vattern/holiot-carrier/README.md

# holiot-carrier
Carrirer board for Holyiots to fit BastardKB housings

PLEASE NOTE: These boards have to be angled when inserting them.

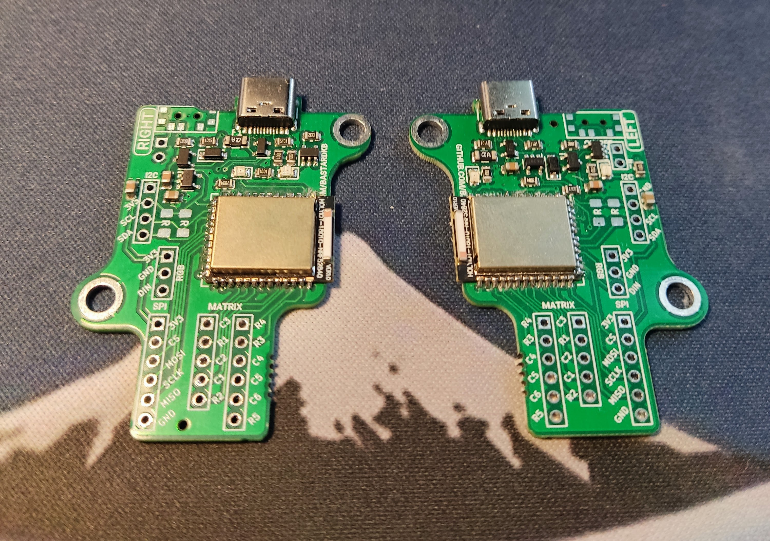
[picture p1: images/pair.jpg]

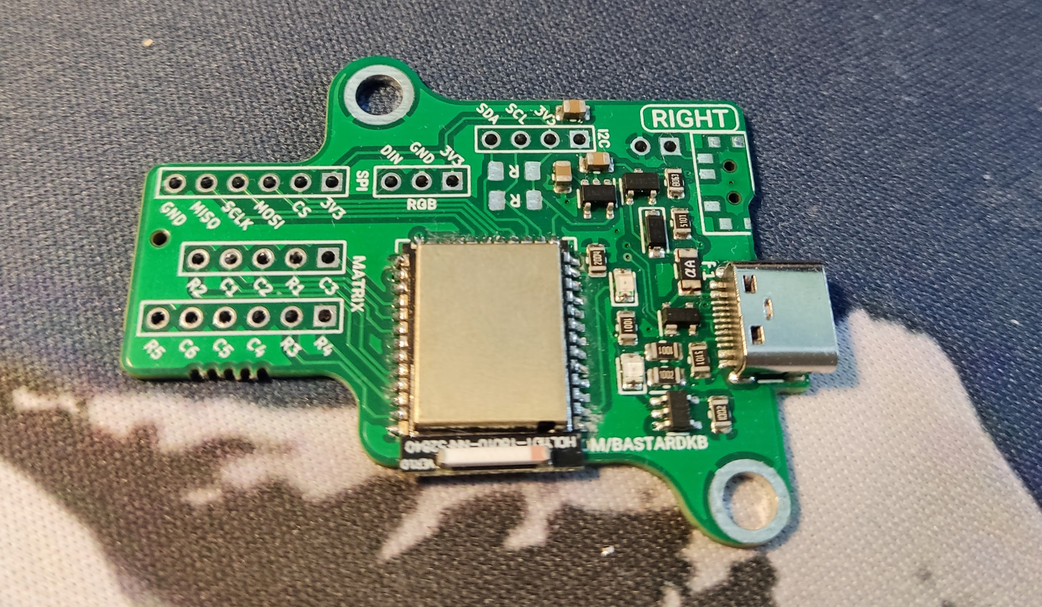
[picture p2: images/right.jpg]
