vattern/holiot-carrier/PCB/PRODUCTION_FILES/bom.xls

Comment | Designator | Footprint | JLCPCB Part #
1k | R7,R12,R14,R19 | R_0805_2012Metric | C17513
806k | R11,R18 | R_0805_2012Metric | C63494
USB_C_Receptacle | J1,J2 | USB_C_Receptacle_HRO_TYPE-C-31-M-12 | C165948
2M | R13,R20 | R_0805_2012Metric | C26112
POWERLED | D1,D5 | D_0805_2012Metric | C84256
1uF | C2,C3,C5,C6 | C_0805_2012Metric | C28323
4.7uF | C1,C4 | C_0805_2012Metric | C1779
500ma | F1,F2 | Fuse_1206_3216Metric | C70068
TP4054 | U1,U2 | SOT-23-5 | C32574
10k | R5,R6,R10,R17 | R_0805_2012Metric | C17414
SR05 | D2,D6 | SOT-143 | C521962
AO3401A | Q1,Q2 | SOT-23 | C15127
1N5819 | D3,D7 | D_SOD-123 | C963381
AP2112K-3.3 | U3,U5 | SOT-23-5 | C86534
LED_Small | D4,D8 | D_0805_2012Metric | C2296
5.1k | R8,R9,R15,R16 | R_0805_2012Metric | C27834
