vattern/holiot-carrier/PCB/PRODUCTION_FILES/BOM-adapter-holyiot.csv

Comment | Designator | Footprint | LCSC
TP4054 | U1,U2 | SOT-23-5 | C32574
5.1k | D1,Q1,F1,C1,Q2,F2,C2,D2,D3,C3,U3,C4,D4,U5,C5,D5,C6,D6,R7,D7,R8,D8,R9,R10,R11,R12,R13,R14,R15,J15,R16,J16,R17,R18,R19,R20 | R_0805_2012Metric
10k | R5,R6 | R_0805_2012Metric | C17414
USB_C_Receptacle | J1,J2 | USB_C_Receptacle_HRO_TYPE-C-31-M-12 | C165948
