vattern/holiot-carrier/PCB/adapter-holyiot.kicad_pcb

## KiCad design PCB/adapter-holyiot.kicad_pcb (2022-06-24)

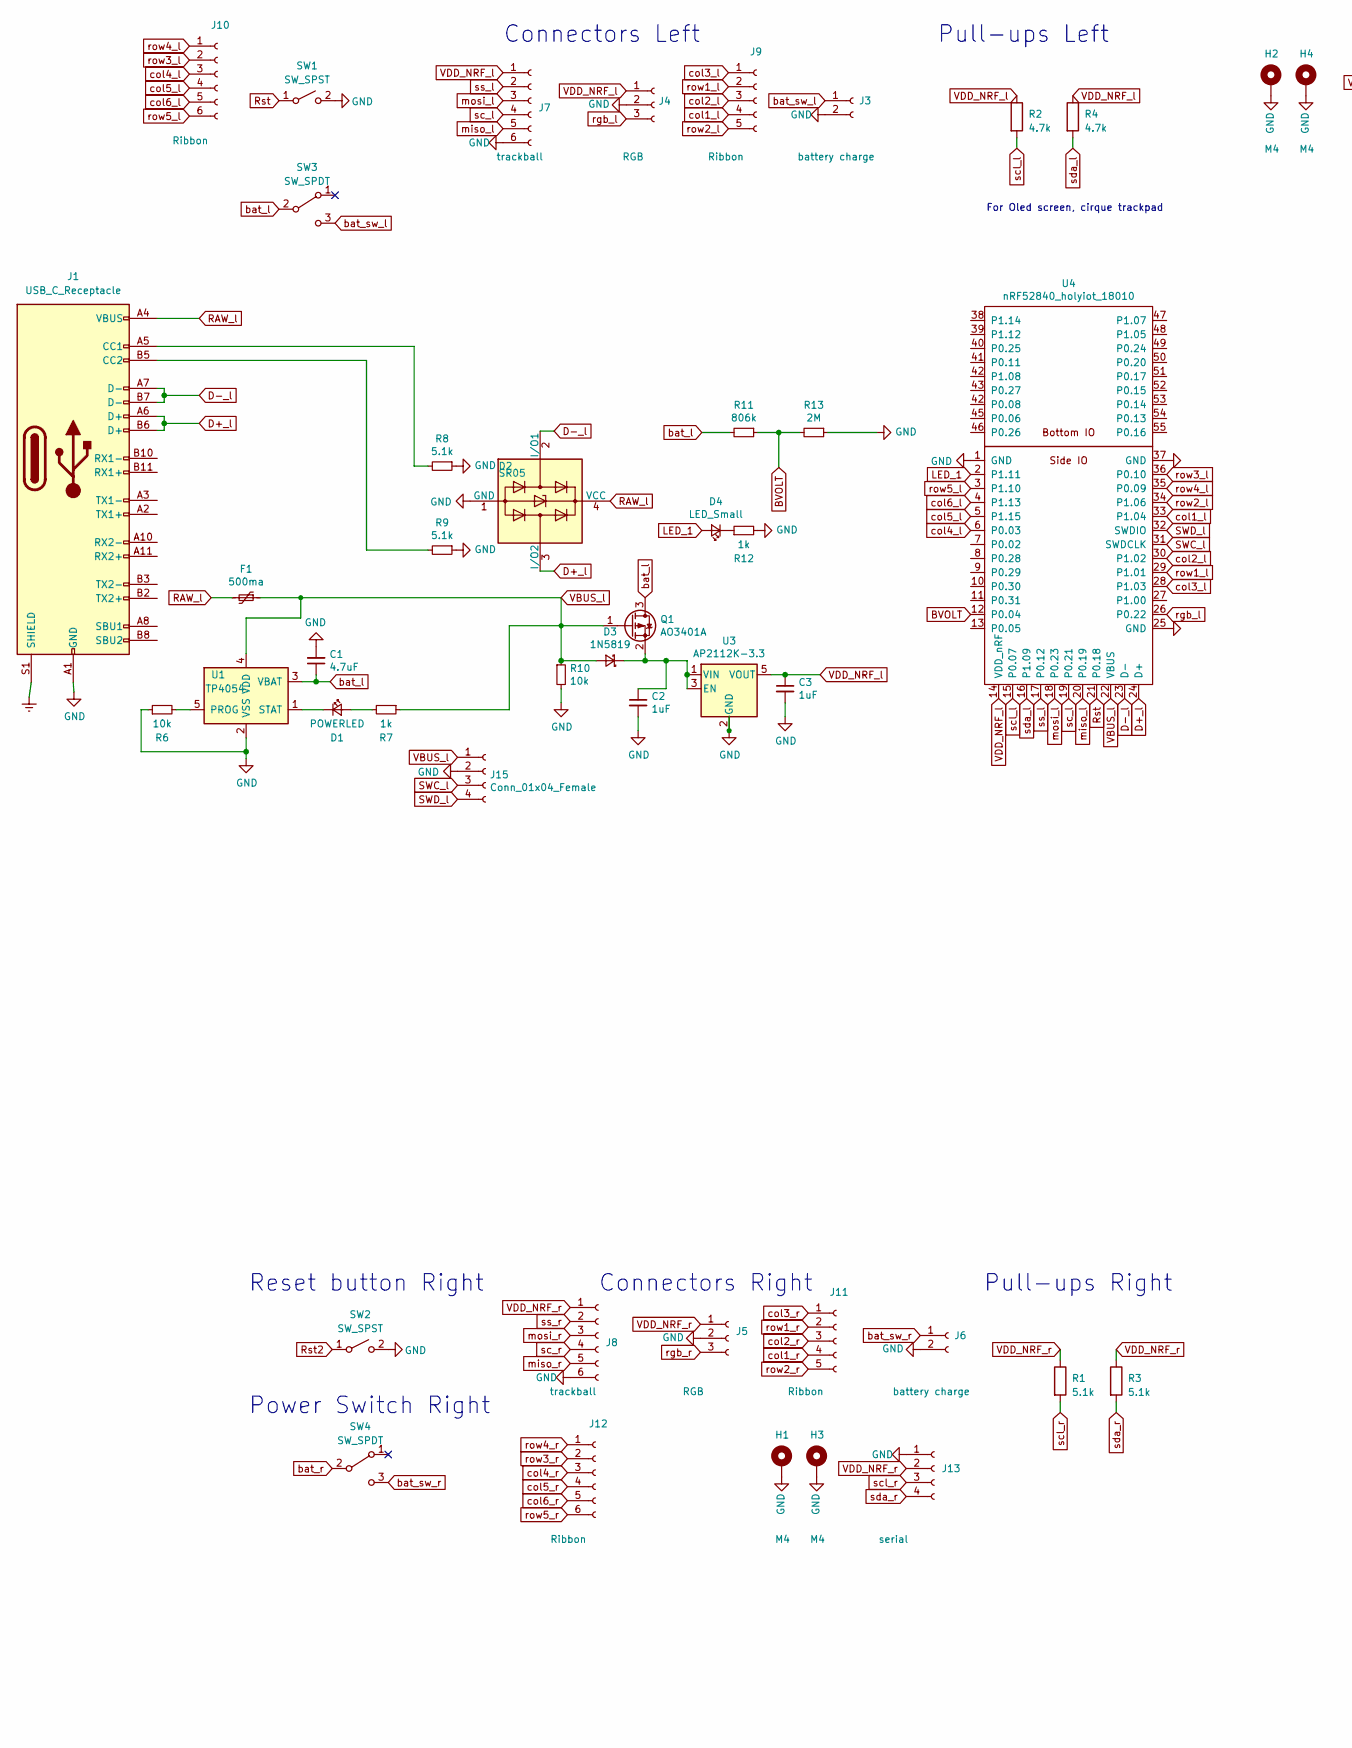
[picture p3: schematic adapter-holyiot.kicad_sch, Holyiot Carrier, part in row 1, column 1]

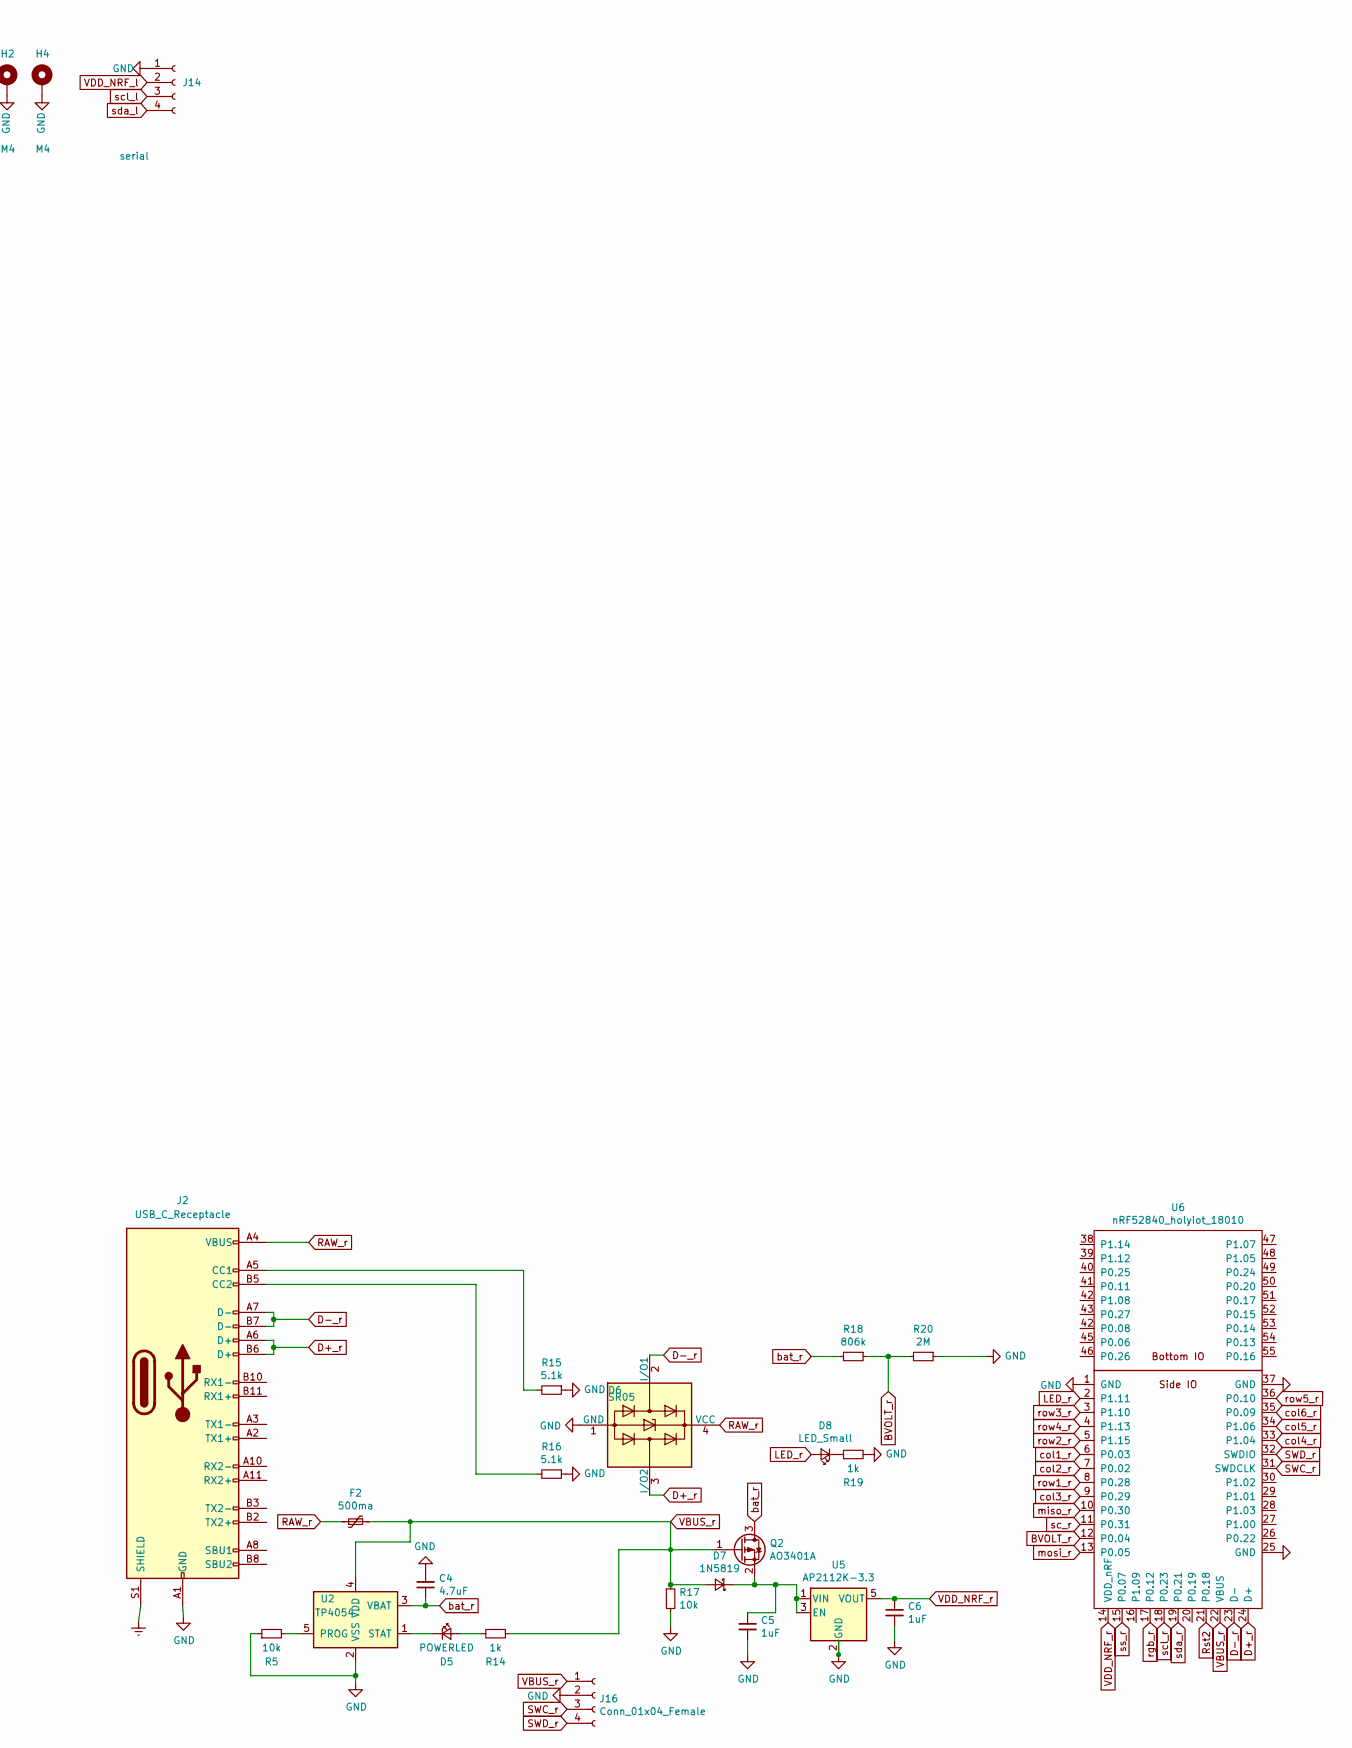
[picture p4: schematic adapter-holyiot.kicad_sch, Holyiot Carrier, part in row 1, column 2]

Parts:
C1, C4: 4.7uF; C_0805_2012Metric
C2, C3, C5, C6: 1uF; C_0805_2012Metric
D1, D5: POWERLED; D_0805_2012Metric
D2, D6: SR05; SOT-143
D3, D7: 1N5819; D_SOD-123
D4, D8: LED_Small; D_0805_2012Metric
F1, F2: 500ma; Fuse_1206_3216Metric
H1, H2, H3, H4: M4; MountingHole_4mm_Pad_thin
J1, J2: USB_C_Receptacle; USB_C_Receptacle_HRO_TYPE-C-31-M-12
J3, J6: battery charge; PinHeader_1x02_P2.54mm_Vertical
J4, J5: RGB; header1x03
J7, J8: trackball; 6_PinHeader
J9, J11: Ribbon; 5_PinHeader
J10, J12: Ribbon; 6_PinHeader
J13, J14: serial; PinHeader_1x04_P2.54mm_Vertical
J15, J16: Conn_01x04_Female; PRO-HDR
Q1, Q2: AO3401A; SOT-23
R1, R3: 5.1k; R_1206_handsolder; JLCPCB BOM 1
R2, R4: 4.7k; R_1206_handsolder; JLCPCB BOM 1
R5, R6, R10, R17: 10k; R_0805_2012Metric
R7, R12, R14, R19: 1k; R_0805_2012Metric
R8, R9, R15, R16: 5.1k; R_0805_2012Metric
R11, R18: 806k; R_0805_2012Metric
R13, R20: 2M; R_0805_2012Metric
SW1, SW2: SW_SPST; PushSwitch
SW3, SW4: SW_SPDT; SW_SPDT+H-MSK12C01_hor(7pin_SMD)
U1, U2: TP4054; SOT-23-5
U3, U5: AP2112K-3.3; SOT-23-5
U4, U6: nRF52840_holyiot_18010

Connections:
BVOLT: R11.1, R13.2, U4.12 (P0.04)
BVOLT_r: R18.1, R20.2, U6.12 (P0.04)
D+_l: D2.3 (I/O2), J1.A6 (D+), J1.B6 (D+), U4.24 (D+)
D+_r: D6.3 (I/O2), J2.A6 (D+), J2.B6 (D+), U6.24 (D+)
D-_l: D2.2 (I/O1), J1.A7 (D-), J1.B7 (D-), U4.23 (D-)
D-_r: D6.2 (I/O1), J2.A7 (D-), J2.B7 (D-), U6.23 (D-)
Earth: J1.S1 (SHIELD), J2.S1 (SHIELD)
GND: C1.2, C2.2, C3.2, C4.2, C5.2, C6.2, D2.1 (GND), D6.1 (GND), H1.1, H2.1, H3.1, H4.1, J1.A1 (GND), J1.A12 (GND), J1.B1 (GND), J1.B12 (GND), J2.A1 (GND), J2.A12 (GND), J2.B1 (GND), J2.B12 (GND), J3.2, J4.2, J5.2, J6.2, J7.6, J8.6, J13.1, J14.1, J15.2, J16.2, R5.1, R6.1, R8.1, R9.1, R10.2, R12.2, R13.1, R15.1, R16.1, R17.2, R19.2, R20.1, SW1.2 (B), SW2.2 (B), U1.2 (VSS), U2.2 (VSS), U3.2 (GND), U4.1 (GND), U4.25 (GND), U4.37 (GND), U5.2 (GND), U6.1 (GND), U6.25 (GND), U6.37 (GND)
LED_1: D4.2 (A), U4.2 (P1.11)
LED_r: D8.2 (A), U6.2 (P1.11)
unnamed: C2.1, D3.1 (K), Q1.2 (S), U3.1 (VIN), U3.3 (EN)
unnamed: C5.1, D7.1 (K), Q2.2 (S), U5.1 (VIN), U5.3 (EN)
unnamed: D1.1 (K), U1.1 (STAT)
unnamed: D1.2 (A), R7.2
unnamed: D4.1 (K), R12.1
unnamed: D5.1 (K), U2.1 (STAT)
unnamed: D5.2 (A), R14.2
unnamed: D8.1 (K), R19.1
unnamed: J1.A5 (CC1), R8.2
unnamed: J1.B5 (CC2), R9.2
unnamed: J2.A5 (CC1), R15.2
unnamed: J2.B5 (CC2), R16.2
unnamed: R5.2, U2.5 (PROG)
unnamed: R6.2, U1.5 (PROG)
RAW_l: D2.4 (VCC), F1.2, J1.A4 (VBUS), J1.A9 (VBUS), J1.B4 (VBUS), J1.B9 (VBUS)
RAW_r: D6.4 (VCC), F2.2, J2.A4 (VBUS), J2.A9 (VBUS), J2.B4 (VBUS), J2.B9 (VBUS)
Rst: SW1.1 (A), U4.21 (P0.18)
Rst2: SW2.1 (A), U6.21 (P0.18)
SWC_l: J15.3, U4.31 (SWDCLK)
SWC_r: J16.3, U6.31 (SWDCLK)
SWD_l: J15.4, U4.32 (SWDIO)
SWD_r: J16.4, U6.32 (SWDIO)
VBUS_l: D3.2 (A), F1.1, J15.1, Q1.1 (G), R7.1, R10.1, U1.4 (VDD), U4.22 (VBUS)
VBUS_r: D7.2 (A), F2.1, J16.1, Q2.1 (G), R14.1, R17.1, U2.4 (VDD), U6.22 (VBUS)
VDD_NRF_l: C3.1, J4.1, J7.1, J14.2, R2.1, R4.1, U3.5 (VOUT), U4.14 (VDD_nRF)
VDD_NRF_r: C6.1, J5.1, J8.1, J13.2, R1.1, R3.1, U5.5 (VOUT), U6.14 (VDD_nRF)
bat_l: C1.1, Q1.3 (D), R11.2, SW3.2 (B), U1.3 (VBAT)
bat_r: C4.1, Q2.3 (D), R18.2, SW4.2 (B), U2.3 (VBAT)
bat_sw_l: J3.1, SW3.3 (C)
bat_sw_r: J6.1, SW4.3 (C)
col1_l: J9.4, U4.33 (P1.04)
col1_r: J11.4, U6.6 (P0.03)
col2_l: J9.3, U4.30 (P1.02)
col2_r: J11.3, U6.7 (P0.02)
col3_l: J9.1, U4.28 (P1.03)
col3_r: J11.1, U6.9 (P0.29)
col4_l: J10.3, U4.6 (P0.03)
col4_r: J12.3, U6.33 (P1.04)
col5_l: J10.4, U4.5 (P1.15)
col5_r: J12.4, U6.34 (P1.06)
col6_l: J10.5, U4.4 (P1.13)
col6_r: J12.5, U6.35 (P0.09)
miso_l: J7.5, U4.20 (P0.19)
miso_r: J8.5, U6.10 (P0.30)
mosi_l: J7.3, U4.18 (P0.23)
mosi_r: J8.3, U6.13 (P0.05)
rgb_l: J4.3, U4.26 (P0.22)
rgb_r: J5.3, U6.17 (P0.12)
row1_l: J9.2, U4.29 (P1.01)
row1_r: J11.2, U6.8 (P0.28)
row2_l: J9.5, U4.34 (P1.06)
row2_r: J11.5, U6.5 (P1.15)
row3_l: J10.2, U4.36 (P0.10)
row3_r: J12.2, U6.3 (P1.10)
row4_l: J10.1, U4.35 (P0.09)
row4_r: J12.1, U6.4 (P1.13)
row5_l: J10.6, U4.3 (P1.10)
row5_r: J12.6, U6.36 (P0.10)
sc_l: J7.4, U4.19 (P0.21)
sc_r: J8.4, U6.11 (P0.31)
scl_l: J14.3, R2.2, U4.15 (P0.07)
scl_r: J13.3, R1.2, U6.18 (P0.23)
sda_l: J14.4, R4.2, U4.16 (P1.09)
sda_r: J13.4, R3.2, U6.19 (P0.21)
ss_l: J7.2, U4.17 (P0.12)
ss_r: J8.2, U6.15 (P0.07)

Notes on the sheet:
Power Switch Right
For Oled screen, cirque trackpad
Connectors Left
Pull-ups Right
Reset button Right
Pull-ups Left
Connectors Right

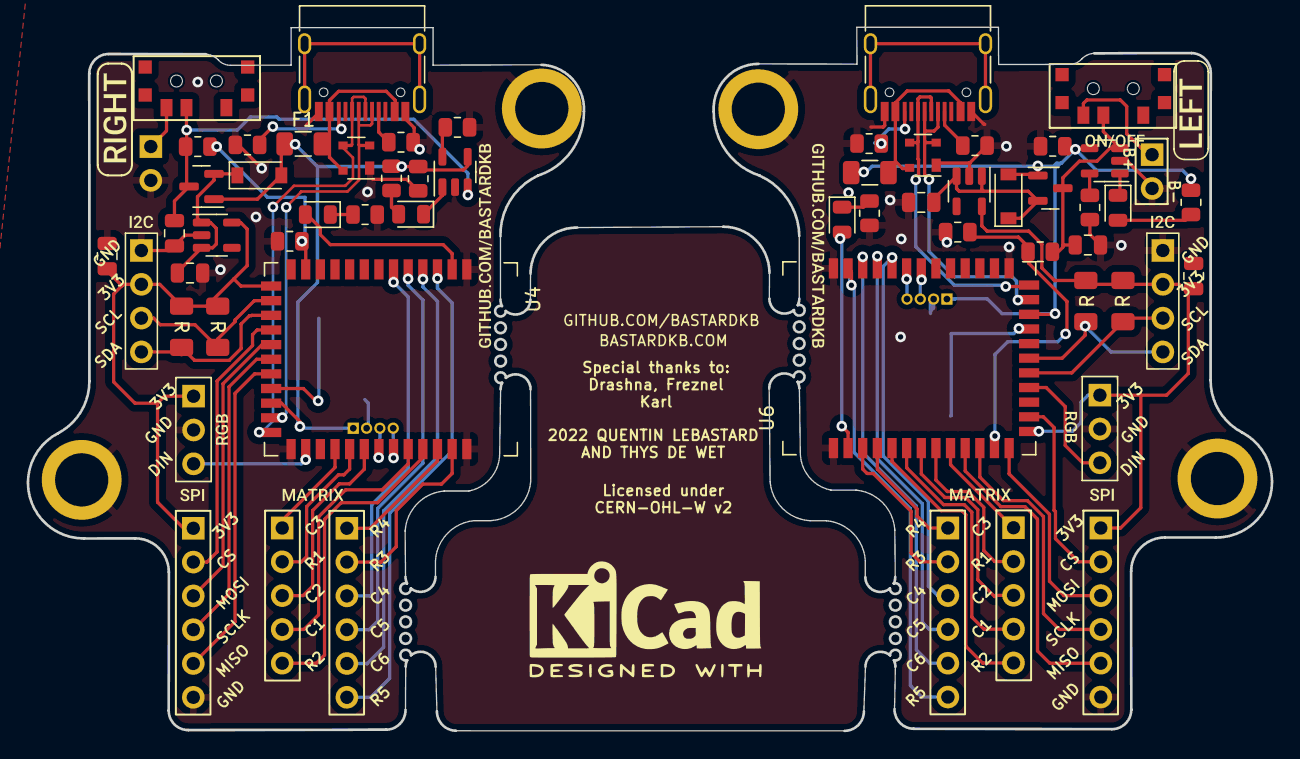
[picture p5: board adapter-holyiot.kicad_pcb from above]

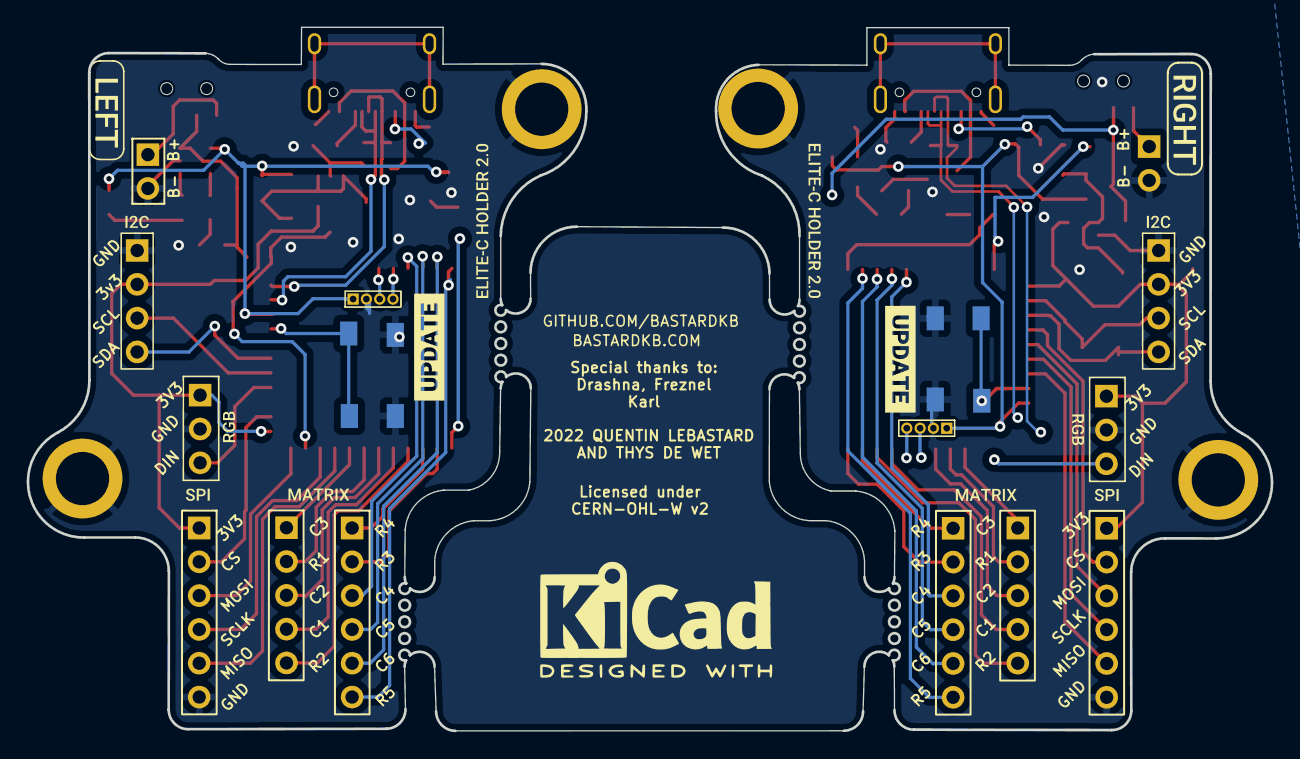
[picture p6: board adapter-holyiot.kicad_pcb from below]

Board: 2 copper layers, 93.5 x 52.9 mm, 95 parts (18 on the bottom side), 76 nets.

Other parts of the board:
kibuzzard-61F01A92, kibuzzard-61F01A92#2: G***; kibuzzard-61F01A92
kibuzzard-61F01B61, kibuzzard-61F01B61#2: G***; kibuzzard-61F01B61
kibuzzard-61F01C84, kibuzzard-61F01C84#2: G***; kibuzzard-61F01C84
kibuzzard-61F019CB, kibuzzard-61F019CB#2, kibuzzard-61F019CB#3, kibuzzard-61F019CB#4: G***; kibuzzard-61F019CB
kibuzzard-61F01940, kibuzzard-61F01940#2, kibuzzard-61F01940#3, kibuzzard-61F01940#4: G***; kibuzzard-61F01940
kibuzzard-61F01957, kibuzzard-61F01957#2, kibuzzard-61F01957#3, kibuzzard-61F01957#4: G***; kibuzzard-61F01957
kibuzzard-620B8D91, kibuzzard-620B8D91#2, kibuzzard-620B8D91#3, kibuzzard-620B8D91#4: G***; kibuzzard-620B8D91
kibuzzard-620B8593: G***; kibuzzard-620B8593
kibuzzard-6208E810, kibuzzard-6208E810#2: G***; kibuzzard-6208E810
kibuzzard-6208EFFE, kibuzzard-6208EFFE#2: G***; kibuzzard-6208EFFE
