vattern/holiot-carrier/(threads)

Thread 2 (2022-10-01):

BOM is incomplete

DasPez, 2022-10-01:
The BOM in PRODUCTIONFILES is missing a lot of parts

https://github.com/vattern/holiot-carrier/blob/2ea75663381d650d06d59db998a7086e5ef48cf4/PCB/PRODUCTION_FILES/BOM-adapter-holyiot.csv

vattern, 2022-10-02:
I've added the bom.xls JLC has for the last order. Please verify it before ordering.

Closed 2022-10-02.

Thread 3 (2022-11-10):

Charging Current

webhostsg, 2022-11-10:
Hi,

Does it support charging? If yes, what is the max charging current. Trying to figure out the best batt capacity.

vattern, 2022-11-10:
The TP4054 handles the charging , and the 10K resistor selected charges at 100mA

Closed 2022-11-10.

Thread 4 (2022-12-25):

Any guides to flashing.

webhostsg, 2022-12-25:
Never used ZMK before, so I'm not sure where to start. How do I flash the firmware to the board? Any guides?

webhostsg, 2022-12-26:
Ok nevermind, i found the SWD and SWC on the PCB

Closed 2022-12-26.

Thread 5 (2023-02-24):

SK6812 LEDs draw current when "off"

DasPez, 2023-02-24:
As the power switch of this carrier board is not easily accessible in my Skeletyl build, I am using ZMKs sleep function to power down the chip automatically after idling for some time. But it still drains a 1200mAh battery in about 4 days in the system off state.

I believe that the SK6812 LEDs are draining the battery while sleeping (without emitting any light) and suggest to add a mosfet to cut off the RGB headers from VCC. ZMK povides the [ext_power](https://zmk.dev/docs/behaviors/power#external-power-control) driver for it.

The [SK6812 data sheet](https://www.digikey.com/htmldatasheets/production/1876263/0/0/1/sk6812-datasheet.html) mentions a typical static power consumption of about 1mA.

The nice!60 keyboard for example implements such a cut off mosfet for the leds as shown in the [schematics](https://nicekeyboards.com/docs/nice-60/schematic/).

Thread 6 (2023-03-10):

Unable to pair

webhostsg, 2023-03-10:
Still a work in progress. I've decided to go with holiot-carrier for my Scylla. JLPCB did PCB with most of the SMDs soldered. Purchased Holyiot 18010 from AliExpress and soldered it on.

Used J-link to flash pca10056_bootloader-0.7.0_s140_6.1.1.hex
bootloader. Copied the zmk-config.

I was able to upload firmware on both, my Mac detected scylla, but I'm unable to connect to it successfully.

Connected left via USB and using https://keyboardchecker.com/ all the left keys registered. Plug in the right side via USB does not detect, not sure if this is the expected result.

Plugged in the battery on both the left and right and was able to detect it, but I still can't pair it. Even tried it on my Android phone and it just would not pair.

What am I doing wrong? Posted on the discord but nobody replied.

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

vattern, 2023-03-11:
The right side will only work if paired to the left side.

So if the left is plugged in, and the right is powered ( battery or USB ) testing on the right should show on the left side as keys . If this does not work I suggest flashing the right side with the left firmware to see if it registers keys.

Also see the ZMK discord as they might have more debugging tips https://discord.com/channels/719497620560543766/1027622967263367259 .

USB logging might also help.

webhostsg, 2023-03-11:
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

Hi vattern,

I've tried flashing the right with the left firmware and it does not register any keys. This is the 2nd PCB with a brand new Holyiot 18010, the first one I tried had the same issues, I thought my soldering was bad on the first one so I ordered a new 18010 and soldered it onto a new PCB. Maybe JLPCB messed up something

webhostsg, 2023-03-11:
Connecting to right side and using `tio`, this is what i get

```
[00:00:10.428,649] <err> zmk: Security failed: CD:39:B1:A7:84:C3 (random) level 1 err 9
[00:00:10.428,833] <dbg> zmk: disconnected: Disconnected from CD:39:B1:A7:84:C3 (random) (reason 0x3d)
[00:00:10.428,833] <dbg> zmk: disconnected: Active profile disconnected
[00:00:10.428,863] <dbg> zmk: update_advertising: advertising from 0 to 2
[00:00:10.429,534] <dbg> zmk: get_selected_endpoint: No endpoints are ready.
[00:00:15.567,260] <dbg> zmk: connected: Connected thread: 0x200039b0
[00:00:15.567,352] <dbg> zmk: connected: Connected CD:39:B1:A7:84:C3 (random)
[00:00:15.568,572] <dbg> zmk: update_advertising: advertising from 0 to 0
[00:00:15.568,572] <dbg> zmk: connected: Active profile connected
[00:00:15.569,915] <dbg> zmk: get_selected_endpoint: Only BLE is ready.
[00:00:15.600,830] <err> zmk: Security failed: CD:39:B1:A7:84:C3 (random) level 1 err 9
[00:00:15.600,982] <dbg> zmk: disconnected: Disconnected from CD:39:B1:A7:84:C3 (random) (reason 0x3d)
[00:00:15.601,013] <dbg> zmk: disconnected: Active profile disconnected
[00:00:15.601,043] <dbg> zmk: update_advertising: advertising from 0 to 2
[00:00:15.601,715] <dbg> zmk: get_selected_endpoint: No endpoints are ready.
[00:00:19.796,478] <dbg> zmk: connected: Connected thread: 0x200039b0
[00:00:19.796,569] <dbg> zmk: connected: Connected CD:39:B1:A7:84:C3 (random)
[00:00:19.797,729] <dbg> zmk: update_advertising: advertising from 0 to 0
[00:00:19.797,729] <dbg> zmk: connected: Active profile connected
[00:00:19.799,072] <dbg> zmk: get_selected_endpoint: Only BLE is ready.
[00:00:19.827,606] <dbg> zmk: split_svc_pos_state_ccc: value 1
[00:00:19.827,789] <dbg> zmk: security_changed: Security changed: CD:39:B1:A7:84:C3 (random) level 2
```
Left side showing this:
```
[00:00:41.290,740] <dbg> zmk: split_central_service_discovery_func: Discover complete
[00:00:41.292,968] <err> zmk: Security failed: DE:08:45:67:61:AA (random) level 1 err 9
[00:00:41.293,151] <dbg> zmk: split_central_disconnected: Disconnected: DE:08:45:67:61:AA (random) (reason 8)
[00:00:41.293,182] <dbg> zmk: release_peripheral_slot: Releasing peripheral slot at 0
[00:00:41.293,487] <dbg> zmk: start_scan: Scanning successfully started
[00:00:41.293,701] <dbg> zmk: disconnected: Disconnected from DE:08:45:67:61:AA (random) (reason 0x08)
[00:00:41.293,701] <dbg> zmk: disconnected: SKIPPING FOR ROLE 0
[00:00:41.299,865] <dbg> zmk: split_central_device_found: [DEVICE]: 20:61:E7:F3:AE:68 (public), AD evt type 0, AD data len 24, RSSI -78
[00:00:41.299,865] <dbg> zmk: split_central_eir_found: [AD]: 1 data_len 1
[00:00:41.299,896] <dbg> zmk: split_central_eir_found: [AD]: 3 data_len 2
[00:00:41.299,896] <dbg> zmk: split_central_eir_found: [AD]: 9 data_len 15
[00:00:41.443,969] <dbg> zmk: split_central_device_found: [DEVICE]: DE:08:45:67:61:AA (random), AD evt type 0, AD data len 25, RSSI -39
[00:00:41.444,000] <dbg> zmk: split_central_eir_found: [AD]: 1 data_len 1
[00:00:41.444,000] <dbg> zmk: split_central_eir_found: [AD]: 2 data_len 2
[00:00:41.444,000] <dbg> zmk: split_central_eir_found: [AD]: 7 data_len 16
[00:00:41.444,030] <dbg> zmk: split_central_eir_found: Found the split service
[00:00:41.444,610] <dbg> zmk: split_central_eir_found: Initiating new connnection
[00:00:41.553,497] <dbg> zmk: split_central_connected: Connected: DE:08:45:67:61:AA (random)
[00:00:41.553,527] <dbg> zmk: split_central_process_connection: Current security for connection: 1
[00:00:41.554,626] <dbg> zmk: split_central_process_connection: New connection params: Interval: 6, Latency: 30, PHY: 1
[00:00:41.554,626] <dbg> zmk: connected: Connected thread: 0x20004f38
[00:00:41.554,656] <dbg> zmk: connected: SKIPPING FOR ROLE 0
[00:00:41.817,382] <dbg> zmk: security_changed: Security changed: DE:08:45:67:61:AA (random) level 2
[00:00:41.832,977] <dbg> zmk: split_central_service_discovery_func: [ATTRIBUTE] handle 42
[00:00:41.832,977] <dbg> zmk: split_central_service_discovery_func: Found split service
[00:00:41.854,949] <dbg> zmk: split_central_chrc_discovery_func: [ATTRIBUTE] handle 43
[00:00:41.854,949] <dbg> zmk: split_central_chrc_discovery_func: Found position state characteristic
[00:00:41.855,041] <dbg> zmk: split_central_subscribe: [SUBSCRIBED]
[00:00:41.884,948] <dbg> zmk: split_central_chrc_discovery_func: [ATTRIBUTE] handle 46
[00:00:41.884,979] <dbg> zmk: split_central_chrc_discovery_func: Found run behavior handle
[00:01:00.412,384] <dbg> zmk: bvd_sample_fetch: ADC raw 863 ~ 632 mV => 886 mV
[00:01:00.412,414] <dbg> zmk: bvd_sample_fetch: Percent: 0
```

vattern, 2023-03-12:
This is something zmk related, your best bet is the zmk discord

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

webhostsg, 2023-03-12:
> This is something zmk related, your best bet is the zmk discord
> […](#)
> On Sat, 11 Mar 2023, 17:01 webhostsg, ***@***.***> wrote: Connecting to right side and using tio, this is what i get [00:00:10.428,649] <err> zmk: Security failed: CD:39:B1:A7:84:C3 (random) level 1 err 9 [00:00:10.428,833] <dbg> zmk: disconnected: Disconnected from CD:39:B1:A7:84:C3 (random) (reason 0x3d) [00:00:10.428,833] <dbg> zmk: disconnected: Active profile disconnected [00:00:10.428,863] <dbg> zmk: update_advertising: advertising from 0 to 2 [00:00:10.429,534] <dbg> zmk: get_selected_endpoint: No endpoints are ready. [00:00:15.567,260] <dbg> zmk: connected: Connected thread: 0x200039b0 [00:00:15.567,352] <dbg> zmk: connected: Connected CD:39:B1:A7:84:C3 (random) [00:00:15.568,572] <dbg> zmk: update_advertising: advertising from 0 to 0 [00:00:15.568,572] <dbg> zmk: connected: Active profile connected [00:00:15.569,915] <dbg> zmk: get_selected_endpoint: Only BLE is ready. [00:00:15.600,830] <err> zmk: Security failed: CD:39:B1:A7:84:C3 (random) level 1 err 9 [00:00:15.600,982] <dbg> zmk: disconnected: Disconnected from CD:39:B1:A7:84:C3 (random) (reason 0x3d) [00:00:15.601,013] <dbg> zmk: disconnected: Active profile disconnected [00:00:15.601,043] <dbg> zmk: update_advertising: advertising from 0 to 2 [00:00:15.601,715] <dbg> zmk: get_selected_endpoint: No endpoints are ready. [00:00:19.796,478] <dbg> zmk: connected: Connected thread: 0x200039b0 [00:00:19.796,569] <dbg> zmk: connected: Connected CD:39:B1:A7:84:C3 (random) [00:00:19.797,729] <dbg> zmk: update_advertising: advertising from 0 to 0 [00:00:19.797,729] <dbg> zmk: connected: Active profile connected [00:00:19.799,072] <dbg> zmk: get_selected_endpoint: Only BLE is ready. [00:00:19.827,606] <dbg> zmk: split_svc_pos_state_ccc: value 1 [00:00:19.827,789] <dbg> zmk: security_changed: Security changed: CD:39:B1:A7:84:C3 (random) level 2 Left side showing this: [00:00:41.290,740] <dbg> zmk: split_central_service_discovery_func: Discover complete [00:00:41.292,968] <err> zmk: Security failed: DE:08:45:67:61:AA (random) level 1 err 9 [00:00:41.293,151] <dbg> zmk: split_central_disconnected: Disconnected: DE:08:45:67:61:AA (random) (reason 8) [00:00:41.293,182] <dbg> zmk: release_peripheral_slot: Releasing peripheral slot at 0 [00:00:41.293,487] <dbg> zmk: start_scan: Scanning successfully started [00:00:41.293,701] <dbg> zmk: disconnected: Disconnected from DE:08:45:67:61:AA (random) (reason 0x08) [00:00:41.293,701] <dbg> zmk: disconnected: SKIPPING FOR ROLE 0 [00:00:41.299,865] <dbg> zmk: split_central_device_found: [DEVICE]: 20:61:E7:F3:AE:68 (public), AD evt type 0, AD data len 24, RSSI -78 [00:00:41.299,865] <dbg> zmk: split_central_eir_found: [AD]: 1 data_len 1 [00:00:41.299,896] <dbg> zmk: split_central_eir_found: [AD]: 3 data_len 2 [00:00:41.299,896] <dbg> zmk: split_central_eir_found: [AD]: 9 data_len 15 [00:00:41.443,969] <dbg> zmk: split_central_device_found: [DEVICE]: DE:08:45:67:61:AA (random), AD evt type 0, AD data len 25, RSSI -39 [00:00:41.444,000] <dbg> zmk: split_central_eir_found: [AD]: 1 data_len 1 [00:00:41.444,000] <dbg> zmk: split_central_eir_found: [AD]: 2 data_len 2 [00:00:41.444,000] <dbg> zmk: split_central_eir_found: [AD]: 7 data_len 16 [00:00:41.444,030] <dbg> zmk: split_central_eir_found: Found the split service [00:00:41.444,610] <dbg> zmk: split_central_eir_found: Initiating new connnection [00:00:41.553,497] <dbg> zmk: split_central_connected: Connected: DE:08:45:67:61:AA (random) [00:00:41.553,527] <dbg> zmk: split_central_process_connection: Current security for connection: 1 [00:00:41.554,626] <dbg> zmk: split_central_process_connection: New connection params: Interval: 6, Latency: 30, PHY: 1 [00:00:41.554,626] <dbg> zmk: connected: Connected thread: 0x20004f38 [00:00:41.554,656] <dbg> zmk: connected: SKIPPING FOR ROLE 0 [00:00:41.817,382] <dbg> zmk: security_changed: Security changed: DE:08:45:67:61:AA (random) level 2 [00:00:41.832,977] <dbg> zmk: split_central_service_discovery_func: [ATTRIBUTE] handle 42 [00:00:41.832,977] <dbg> zmk: split_central_service_discovery_func: Found split service [00:00:41.854,949] <dbg> zmk: split_central_chrc_discovery_func: [ATTRIBUTE] handle 43 [00:00:41.854,949] <dbg> zmk: split_central_chrc_discovery_func: Found position state characteristic [00:00:41.855,041] <dbg> zmk: split_central_subscribe: [SUBSCRIBED] [00:00:41.884,948] <dbg> zmk: split_central_chrc_discovery_func: [ATTRIBUTE] handle 46 [00:00:41.884,979] <dbg> zmk: split_central_chrc_discovery_func: Found run behavior handle [00:01:00.412,384] <dbg> zmk: bvd_sample_fetch: ADC raw 863 ~ 632 mV => 886 mV [00:01:00.412,414] <dbg> zmk: bvd_sample_fetch: Percent: 0 — Reply to this email directly, view it on GitHub <[#6 (comment)](https://github.com/vattern/holiot-carrier/issues/6#issuecomment-1464953311)>, or unsubscribe <https://github.com/notifications/unsubscribe-auth/ABDWJ24CXIEEMA3EXQMTLCLW3SVXTANCNFSM6AAAAAAVWZG7P4> . You are receiving this because you commented.Message ID: ***@***.***>

Yes, got it fixed with some help from zmk discord. Thank you so much for your great work!
