vattern/holiot-carrier/(commit log)

2022-06-24 Add board
    [adapter-holyiot.kicad_pcb, adapter-holyiot.kicad_sch]
2022-06-24 Add production files
    [BOM-adapter-holyiot.csv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]
2022-10-02 Add bom.xls from last order
    [bom.xls]
