vattern/holiot-carrier/(notices)

Notices in the files:
PCB/adapter-holyiot.kicad_sch:
Licensed under CERN-OHL-W v2
PCB/adapter-holyiot.kicad_pcb:
CERN-OHL-W v2
